eavcodes/desbravatech_kicad_libs/README.md

# desbravatech_kicad_libs
Most used Kicad symbols and footprints designed by us and collected on the internet. 

It's free and you are invited to contribute to this professional Kicad components and footprints lib!

If you have any questions, please send a message.
