eavcodes/desbravatech_kicad_libs/basic-configs/design_rule_kicad_value_01.png

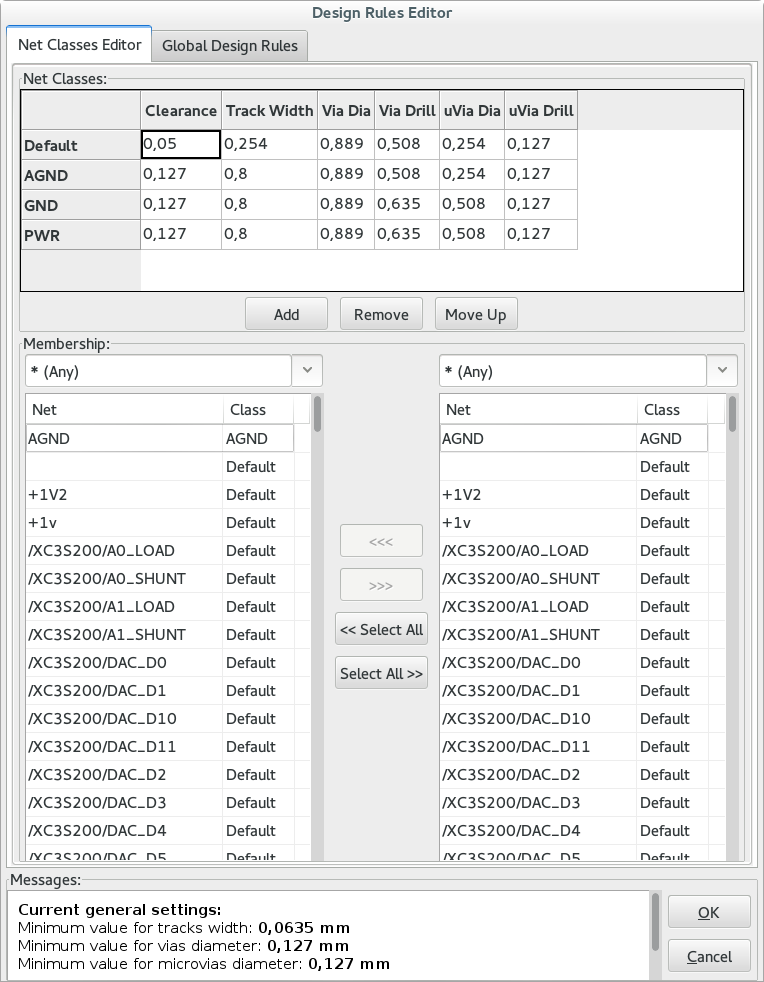
basic-configs/design_rule_kicad_value_01.png
