eavcodes/desbravatech_kicad_libs/basic-configs/design_rule_kicad_value_02.png

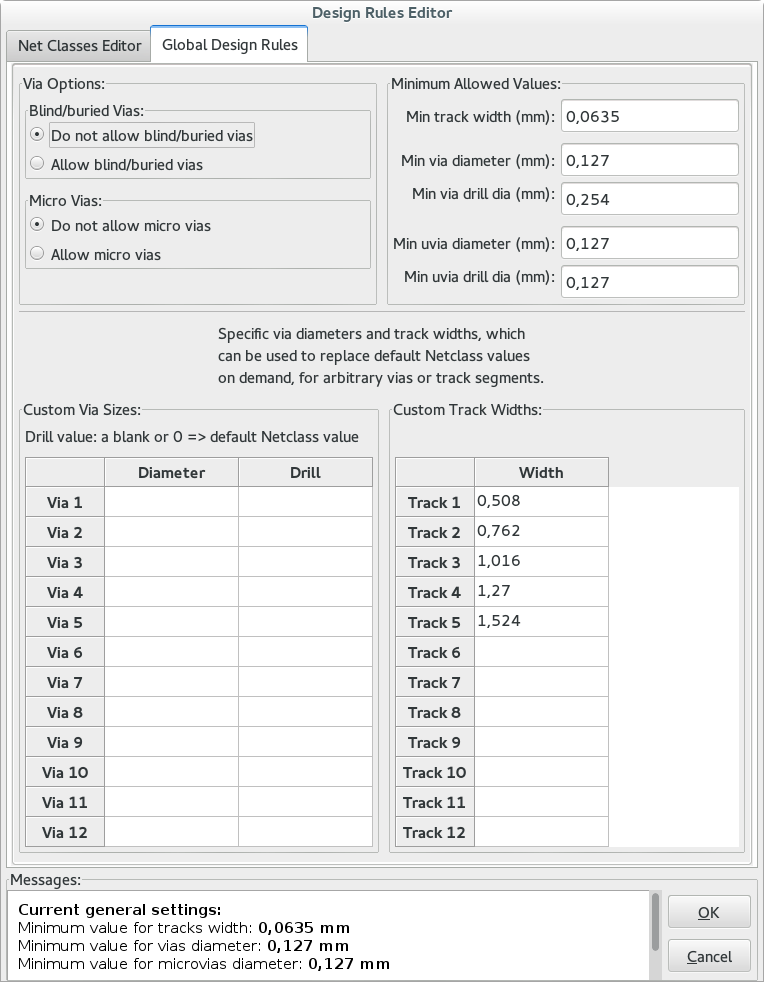
basic-configs/design_rule_kicad_value_02.png
