eavcodes/desbravatech_kicad_libs/designRules_2018.PNG

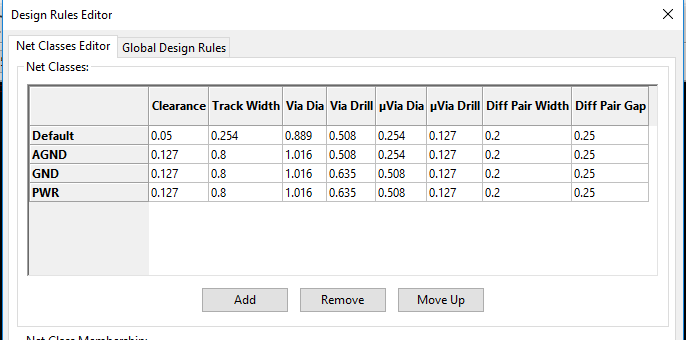
designRules_2018.PNG
