eavcodes/desbravatech_kicad_libs/designRulesGlobal_2018.PNG

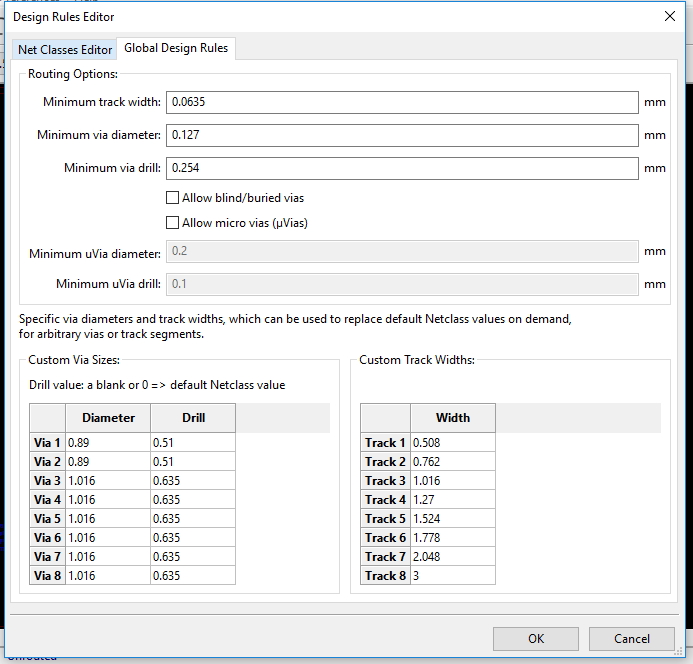
designRulesGlobal_2018.PNG
