eavcodes/desbravatech_kicad_libs/bom/saxon_windows_config_plugin.png

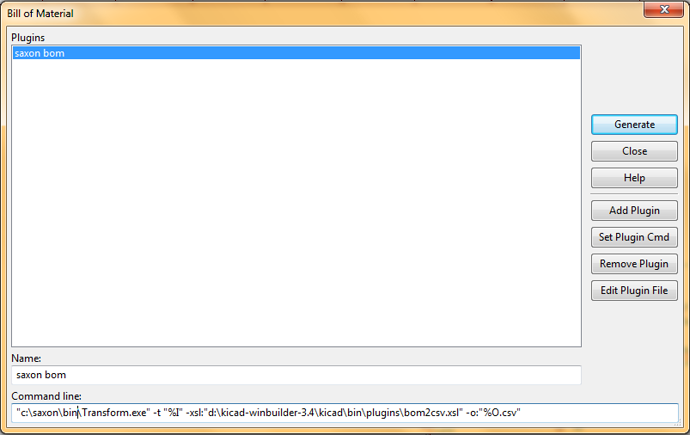
bom/saxon_windows_config_plugin.png
