eavcodes/desbravatech_kicad_libs/3d/J1021C.stp

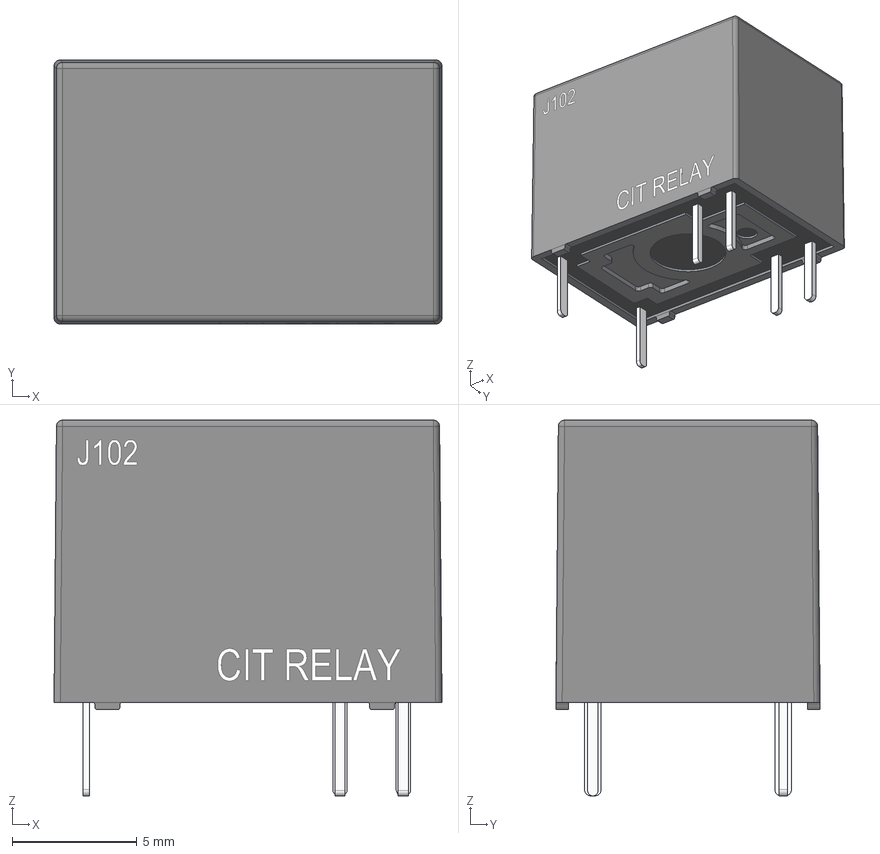
[picture p6: CAD file, 2025-11-07]
3d/J1021C.stp
15.5 x 10.6 x 15.1 mm
J102_Cover
J102_Terminal x 2
J102_Terminal_SQ x 2
J102_Terminal_2 x 2
J102_Base
