eavcodes/desbravatech_kicad_libs/footprints/3d_models/5223--3DModel-STEP-630548.STEP

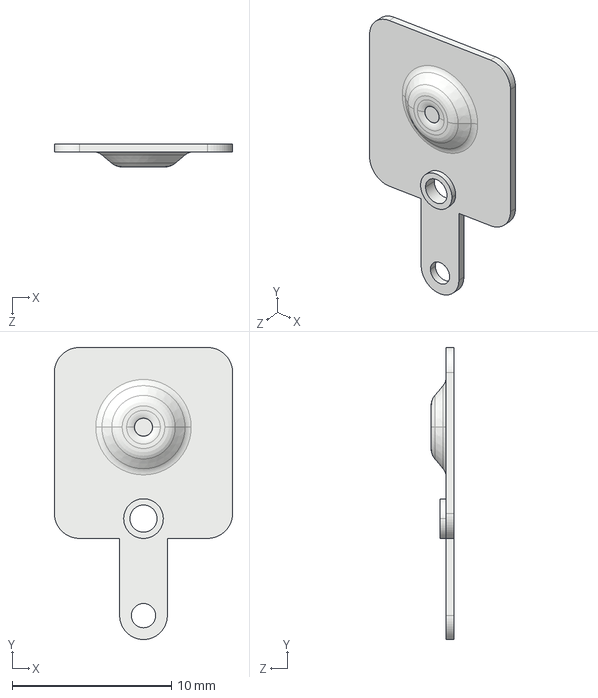
[picture p7: CAD file, 2025-08-11]
footprints/3d_models/5223--3DModel-STEP-630548.STEP
11.2 x 18.3 x 1.45 mm
