eavcodes/desbravatech_kicad_libs/3d/TS11-674-43-BK-100-RA-D.step

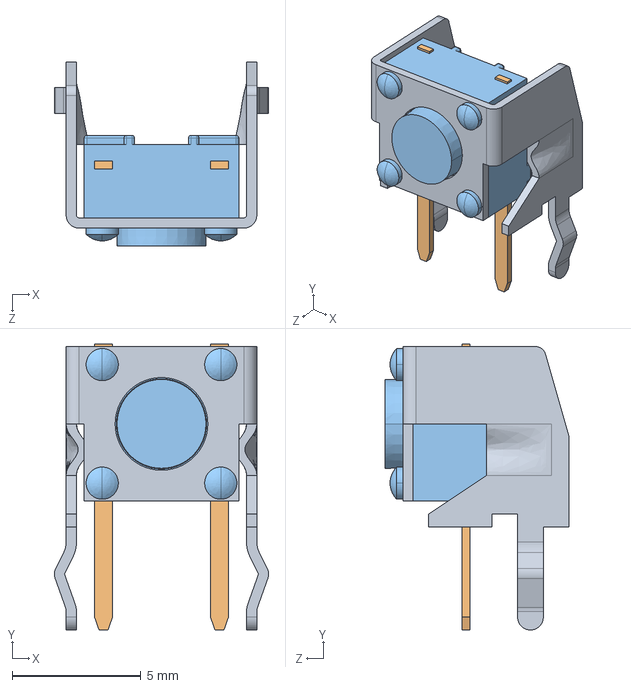
[picture p8: CAD file, 2025-10-24]
3d/TS11-674-43-BK-100-RA-D.step
8.31 x 11.1 x 7.15 mm
