eavcodes/desbravatech_kicad_libs/footprints/3d_models/SN-T5-1--3DModel-STEP-46669.STEP

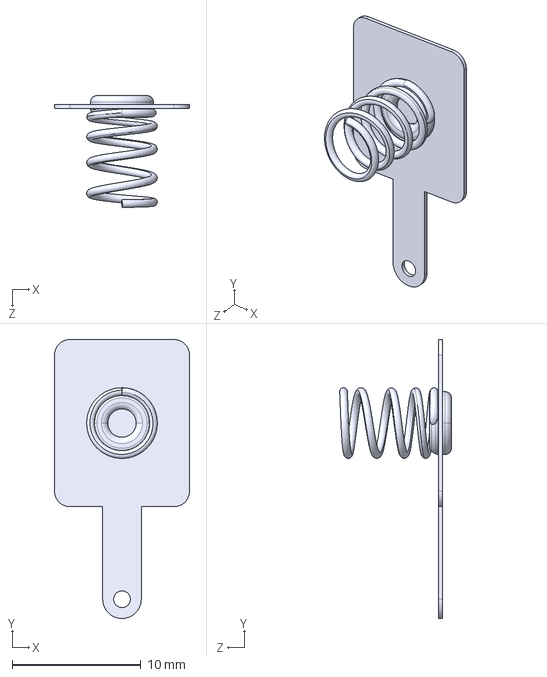
[picture p9: CAD file, 2025-08-11]
footprints/3d_models/SN-T5-1--3DModel-STEP-46669.STEP
10.5 x 21.7 x 8.70 mm
