eavcodes/desbravatech_kicad_libs/3d/Panasonic%20LQ%20Series%20Relays%20CAD%20Drawing%20ALQ1%20%28STEP%29.step

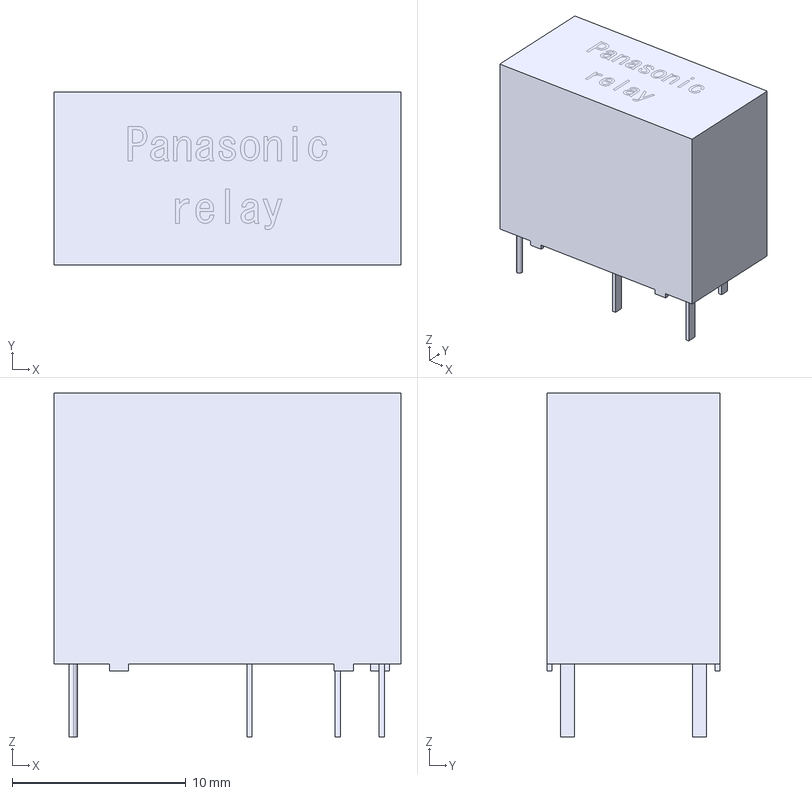
[picture p10: CAD file, 2025-10-24]
3d/Panasonic%20LQ%20Series%20Relays%20CAD%20Drawing%20ALQ1%20%28STEP%29.step
20.0 x 10.0 x 19.8 mm
