eavcodes/desbravatech_kicad_libs/footprints/3d_models/srr1208-101yl.stp

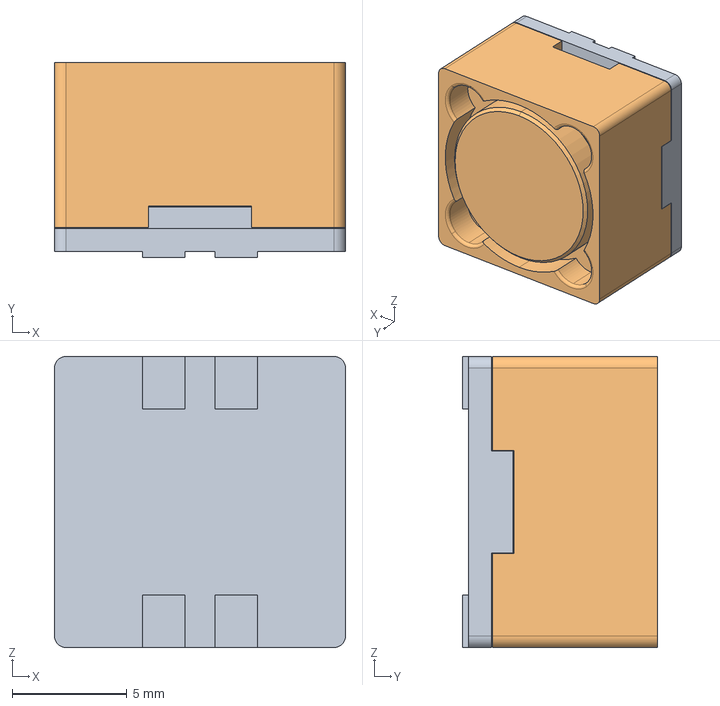
[picture p11: CAD file, 2024-09-12]
footprints/3d_models/srr1208-101yl.stp
12.7 x 8.50 x 12.7 mm
