eavcodes/desbravatech_kicad_libs/3d/TS32-7-35-BK-B-260-RA-SMT-TR.step

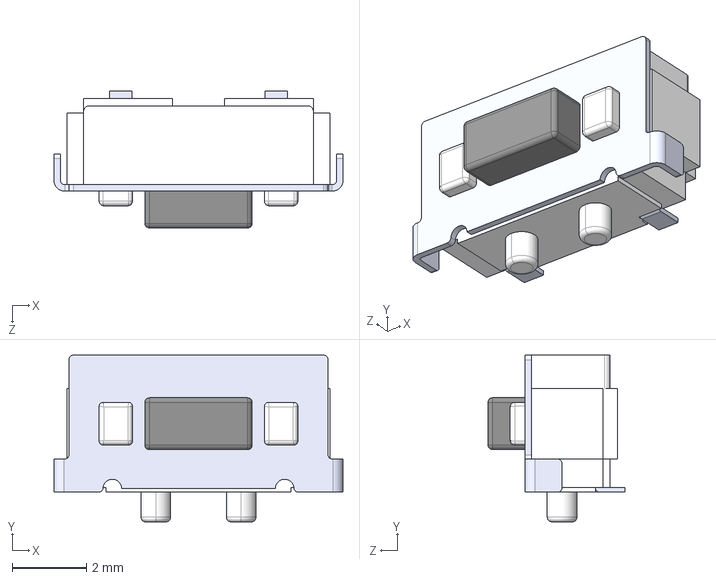
[picture p12: CAD file, 2025-10-24]
3d/TS32-7-35-BK-B-260-RA-SMT-TR.step
7.80 x 4.50 x 3.70 mm
