eavcodes/desbravatech_kicad_libs/footprints/3d_models/IRM-45.STEP

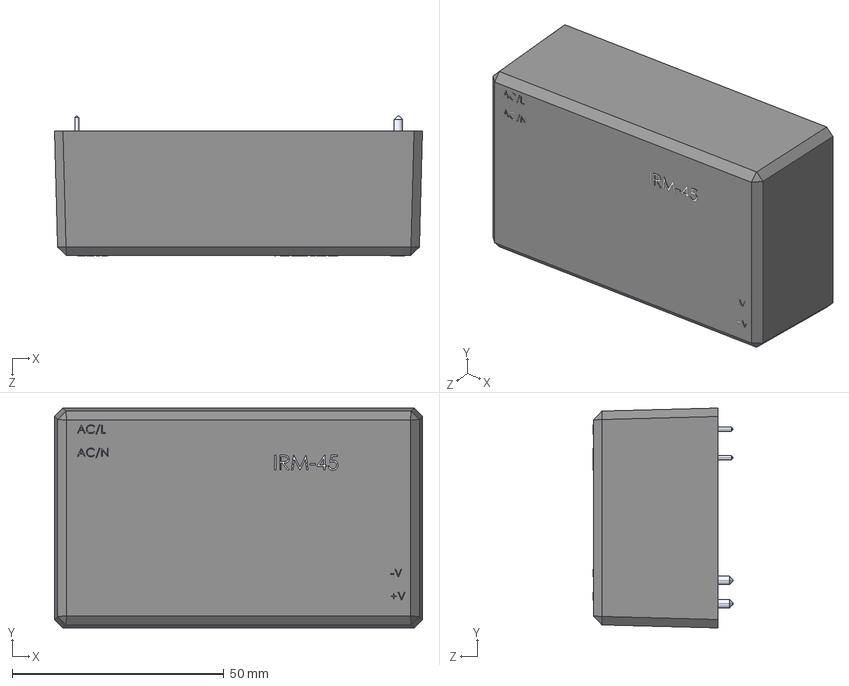
[picture p13: CAD file, 2024-09-12]
footprints/3d_models/IRM-45.STEP
87.0 x 52.0 x 33.1 mm
