eavcodes/desbravatech_kicad_libs/3d/PR8-5V-450-1A.step

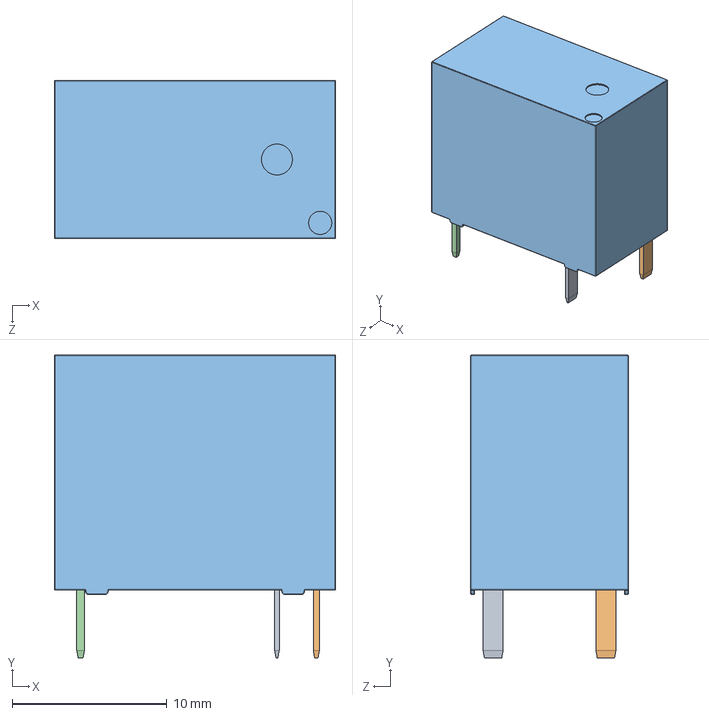
[picture p14: CAD file, 2025-09-16]
3d/PR8-5V-450-1A.step
18.2 x 19.6 x 10.2 mm
