eavcodes/desbravatech_kicad_libs/footprints/3d_models/ESP32-S3-WROOM-1-N16R8.STEP

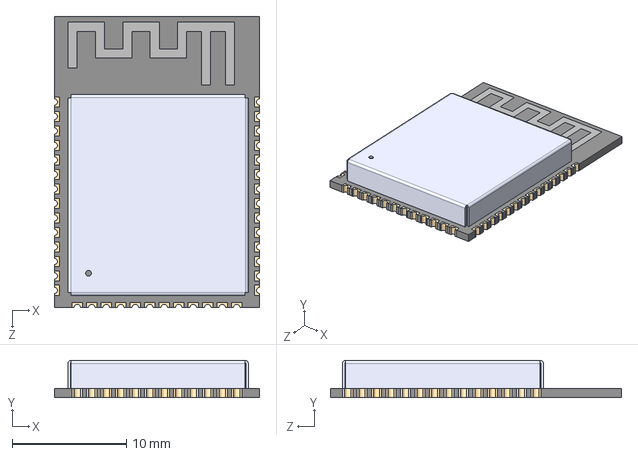
[picture p15: CAD file, 2024-02-02]
footprints/3d_models/ESP32-S3-WROOM-1-N16R8.STEP
18.0 x 3.25 x 25.5 mm
