eavcodes/desbravatech_kicad_libs/footprints/3d_models/CUI_DEVICES_SJ2-35364B-SMT-TR.step

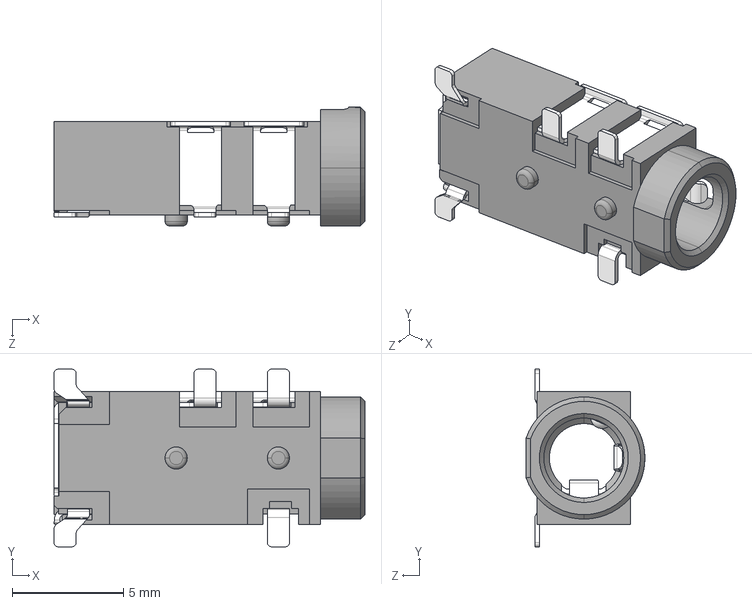
[picture p16: CAD file, 2024-01-29]
footprints/3d_models/CUI_DEVICES_SJ2-35364B-SMT-TR.step
14.0 x 8.00 x 5.35 mm
