eavcodes/desbravatech_kicad_libs/3d/V3PAN50-M3_I.step

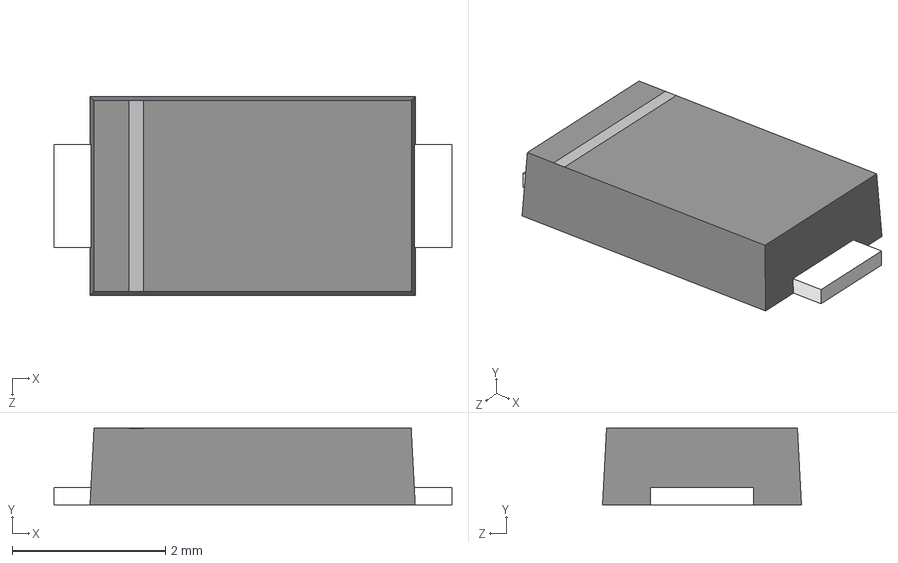
[picture p17: CAD file, 2025-02-25]
3d/V3PAN50-M3_I.step
5.20 x 1.00 x 2.60 mm
