eavcodes/desbravatech_kicad_libs/footprints/3d_models/USBC_16P_USB2.0_USB4105GFA120.step

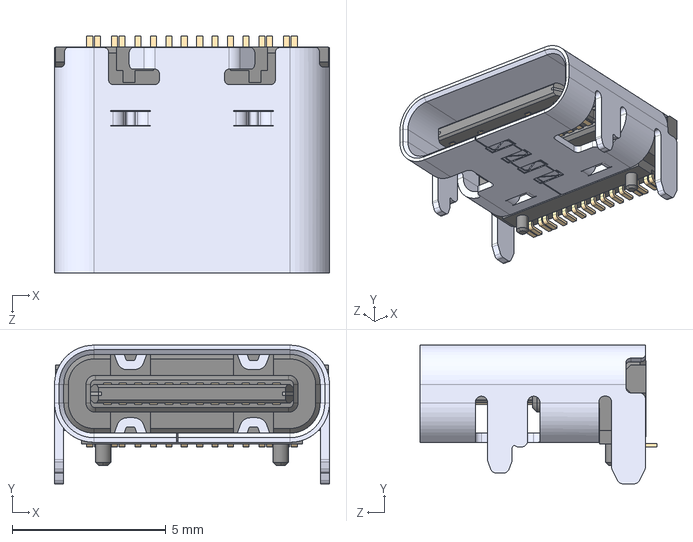
[picture p18: CAD file, 2023-12-15]
footprints/3d_models/USBC_16P_USB2.0_USB4105GFA120.step
8.94 x 4.51 x 7.71 mm
