eavcodes/desbravatech_kicad_libs/footprints/3d_models/BM83SM1-00TA--3DModel-STEP-56544.STEP

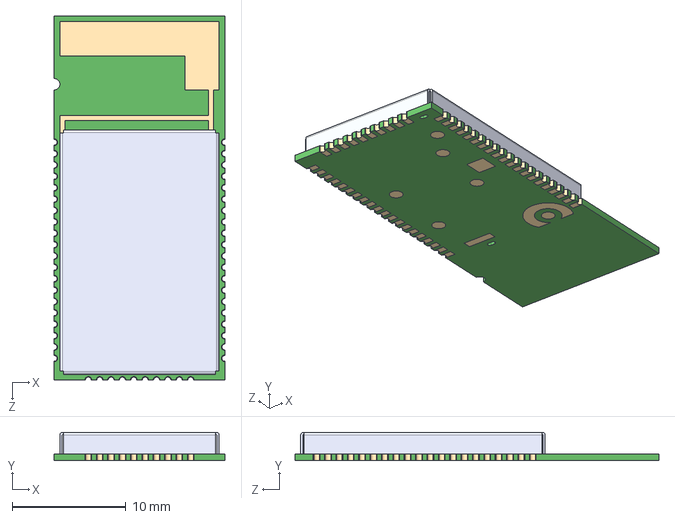
[picture p19: CAD file, 2023-12-12]
footprints/3d_models/BM83SM1-00TA--3DModel-STEP-56544.STEP
15.0 x 2.50 x 32.0 mm
