eavcodes/desbravatech_kicad_libs/footprints/3d_models/USB_C_MOLEX_2171750001.step

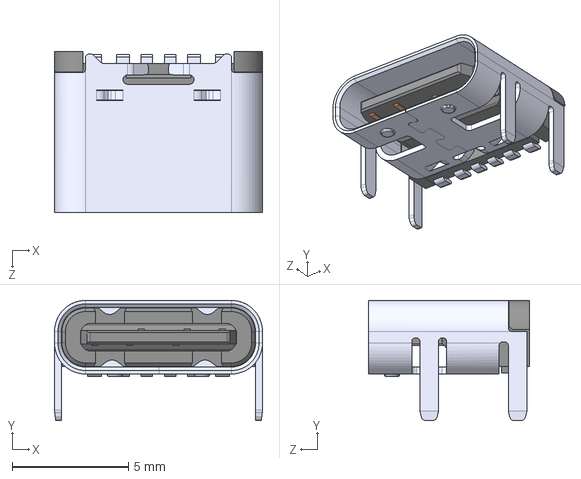
[picture p20: CAD file, 2023-12-12]
footprints/3d_models/USB_C_MOLEX_2171750001.step
8.94 x 5.16 x 6.90 mm
