eavcodes/desbravatech_kicad_libs/footprints/3d_models/SLP1210N6_SEM.step

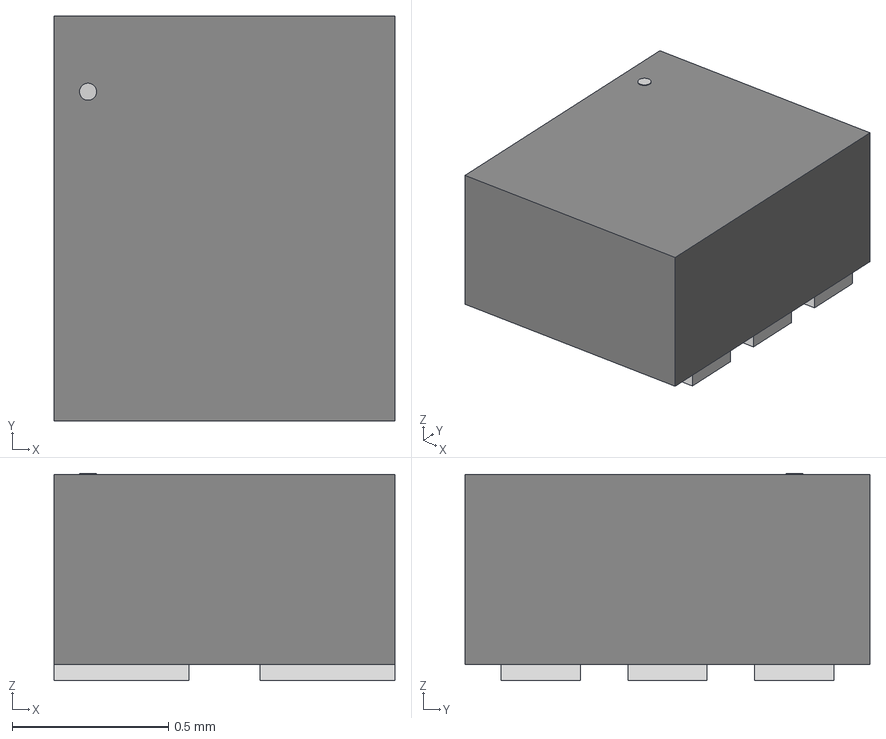
[picture p21: CAD file, 2023-11-29]
footprints/3d_models/SLP1210N6_SEM.step
1.09 x 1.30 x 0.663 mm
