eavcodes/desbravatech_kicad_libs/footprints/3d_models/HS3001.stp

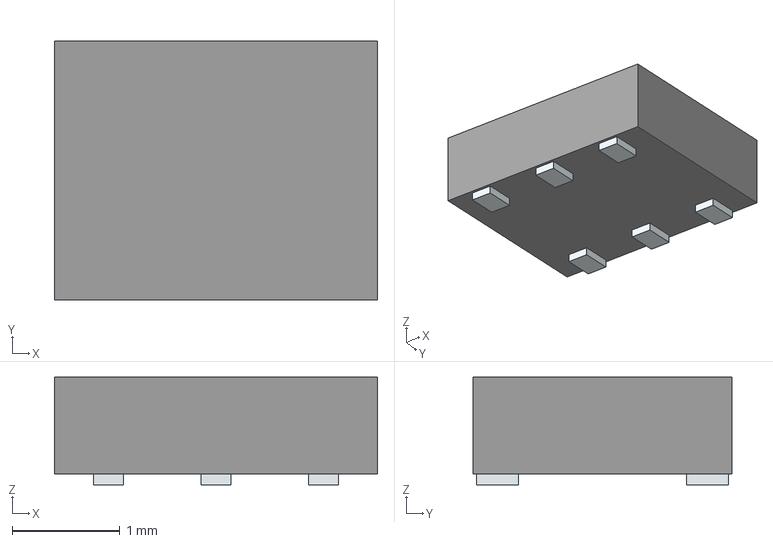
[picture p22: CAD file, 2023-11-29]
footprints/3d_models/HS3001.stp
3.00 x 2.41 x 1.00 mm
Pins
