eavcodes/desbravatech_kicad_libs/footprints/3d_models/TC33X-2-202E.step

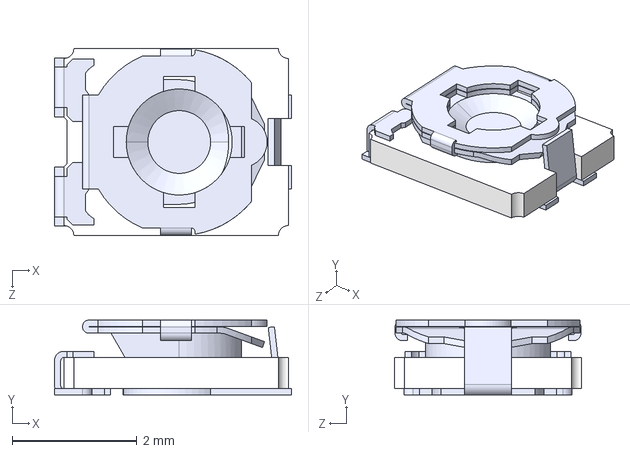
[picture p23: CAD file, 2023-11-29]
footprints/3d_models/TC33X-2-202E.step
3.80 x 1.20 x 3.00 mm
