eavcodes/desbravatech_kicad_libs/footprints/3d_models/R7FA4E2B93CFM#BA0.stp

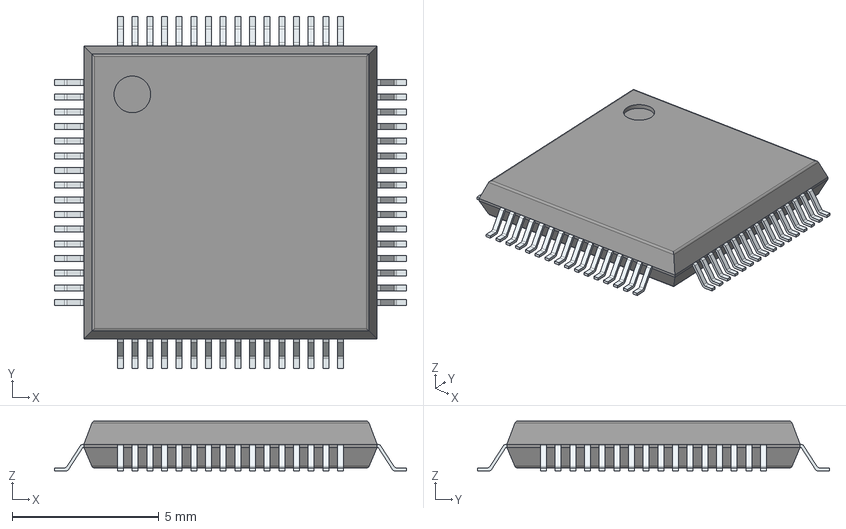
[picture p24: CAD file, 2023-11-29]
footprints/3d_models/R7FA4E2B93CFM#BA0.stp
12.0 x 12.0 x 1.70 mm
PinsArrayLR
PinsArrayTB
