eavcodes/desbravatech_kicad_libs/footprints/3d_models/LGA-6-40181.step

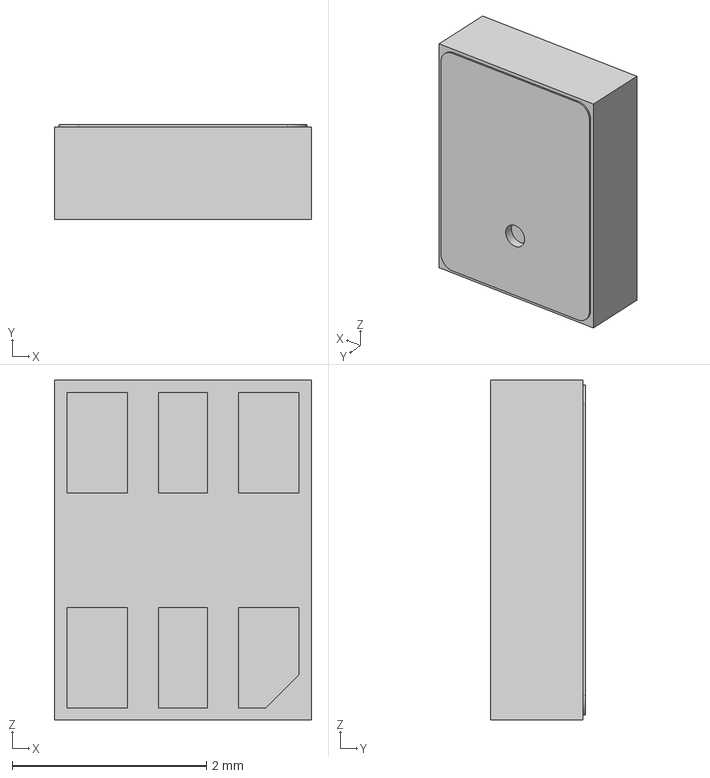
[picture p25: CAD file, 2023-08-16]
footprints/3d_models/LGA-6-40181.step
2.65 x 0.98 x 3.50 mm
