eavcodes/desbravatech_kicad_libs/footprints/3d_models/LFQFP-48-Renesas.stp

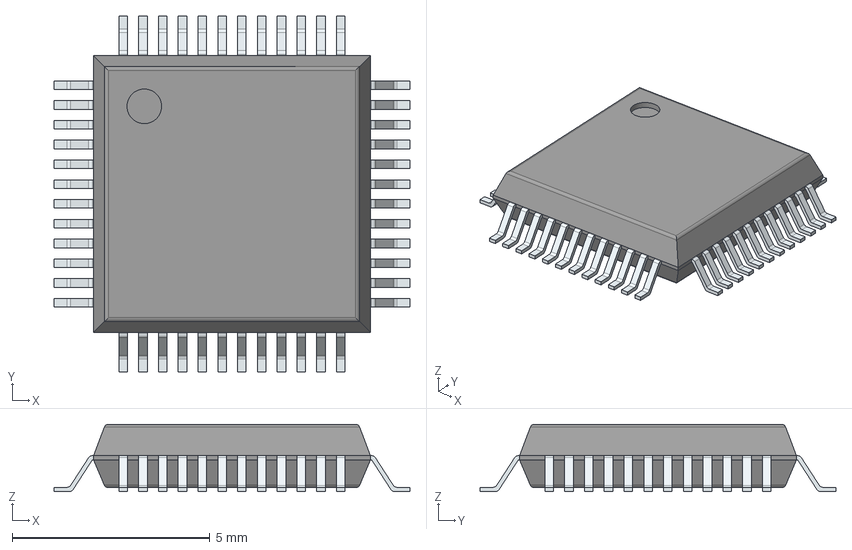
[picture p26: CAD file, 2023-06-05]
footprints/3d_models/LFQFP-48-Renesas.stp
9.00 x 9.00 x 1.70 mm
PinsArrayLR
PinsArrayTB
