eavcodes/desbravatech_kicad_libs/footprints/3d_models/AAVID_576602B_heat_sink.step

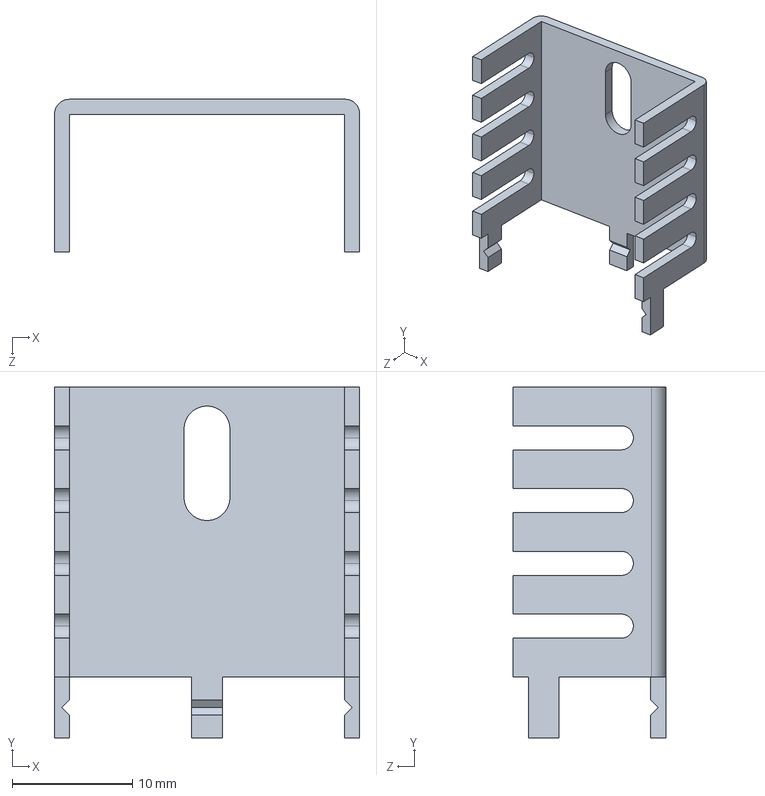
[picture p27: CAD file, 2022-03-22]
footprints/3d_models/AAVID_576602B_heat_sink.step
25.4 x 29.2 x 12.7 mm
