eavcodes/desbravatech_kicad_libs/footprints/3d_models/Thermalloy_6021bg.STEP

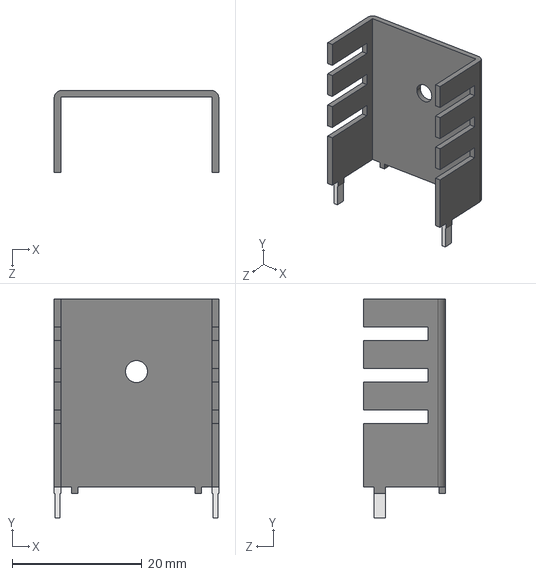
[picture p28: CAD file, 2022-03-22]
footprints/3d_models/Thermalloy_6021bg.STEP
25.4 x 33.8 x 12.7 mm
