eavcodes/desbravatech_kicad_libs/footprints/3d_models/LQFP64_7x7mm.step

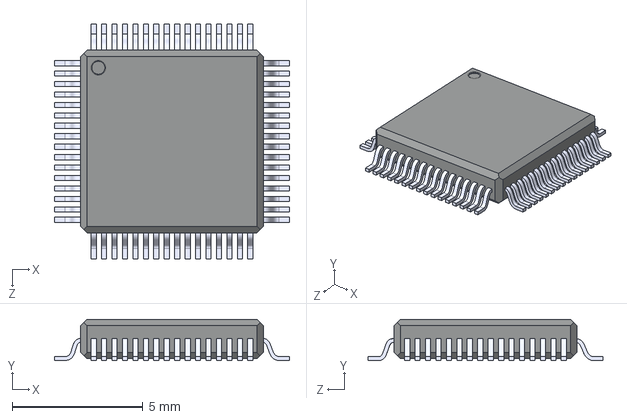
[picture p29: CAD file, 2022-03-16]
footprints/3d_models/LQFP64_7x7mm.step
9.00 x 1.58 x 9.00 mm
