eavcodes/desbravatech_kicad_libs/footprints/3d_models/LQFP64-10x10.step

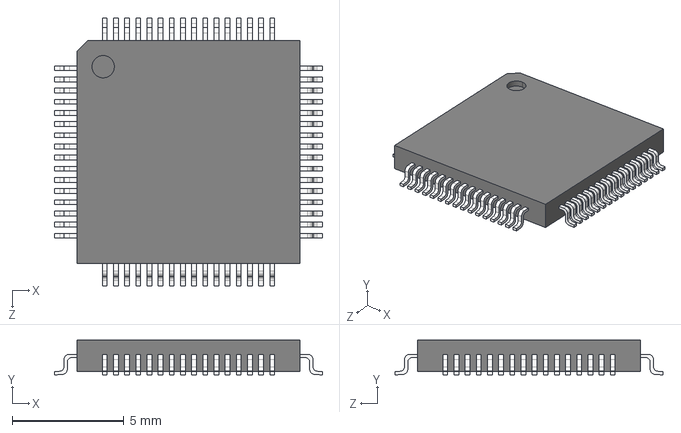
[picture p30: CAD file, 2022-03-16]
footprints/3d_models/LQFP64-10x10.step
12.0 x 1.56 x 12.0 mm
