eavcodes/desbravatech_kicad_libs/footprints/3d_models/RM-0505S.step

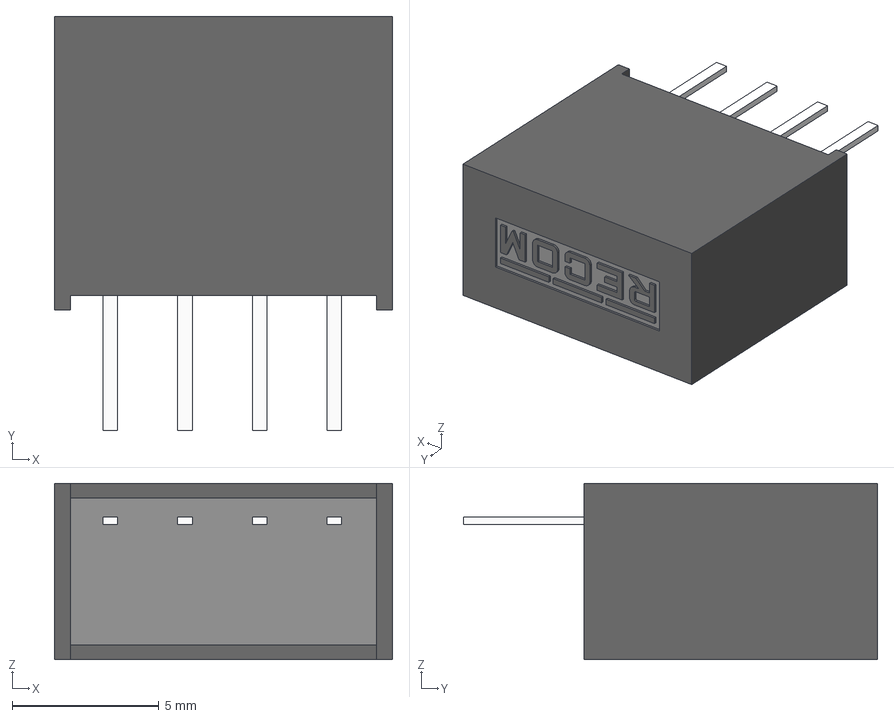
[picture p31: CAD file, 2022-02-24]
footprints/3d_models/RM-0505S.step
11.5 x 14.1 x 6.00 mm
