eavcodes/desbravatech_kicad_libs/(list of files, cad)

Other CAD files:
3d/0697H9160-02.step
footprints/3d_models/686110148922.step
footprints/3d_models/HR911105A.step
