eavcodes/desbravatech_kicad_libs/(commit log)

2020-07-09 added digikey symbols and footprints. Joined together symbols and footprints repositories
2020-07-09 added config files, basic design rules and bom plugin tutorial with Saxon
2020-07-15 Adicionado novo componente (símbolo e footprint)
    Adicionado TI TPS65131
2020-07-15 novo footprint BPM15-SERIES Murata
2020-07-15 BMP15-SERIES updated footprint
2020-07-16 update footprints and labels
2020-07-27 Added and updated mounting holes
    M1, M3, M4, M6 mounting holes
2020-07-29 Adicionado novos símbolos e footprints
2020-08-05 new item relay 5 pin
    Included new symbol. Relay 5 pin
2020-09-23 updated footprints
2020-10-14 Add Battery
2021-08-10 added items
    - TO-46-2 reverse footprint
    - SOP-18 footprint
2022-01-26 Create bionexus_symbols_lib.kicad_sym
    Migrate symbols lib to new KiCAD v6
2022-01-28 Update bionexus_symbols_lib.kicad_sym
    fixed symbol MX25V1635F grid position
2022-01-28 Update bionexus_symbols_lib.kicad_sym
    fixed symbols grid
2022-02-18 atualização de componentes
    adicionado componentes
    cpc5902
    dgd0506
    max 31865
    lmp91200
    rm0505s
2022-02-18 migrated symbols libs to kicad 6
2022-02-21 ajuste estetico do back gorund de componentes recentes
2022-02-24 added RM-0505S footprint
    Created 3d_models folder for 3d view
    [RM-0505S.step]
2022-03-08 added new symbols
    . BD41041FJ CAN bus transceiver
    . PIC18F27Q84 MCU 8-bit Microchip
    . TMCS1108 hall-effect current sensor
2022-03-10 Update bionexus_symbols_lib.kicad_sym
    Added TMCS1108A hall-effect current sensor from Texas Instruments
2022-03-14 added SSOP-5 footprint
    [SSOP-5.step]
2022-03-14 added BU12TD3WG symbol
    Voltage regulator 1.2V
2022-03-14 added BUxxTD3WG voltage regulators series from Rohm semiconductor
2022-03-14 sata header symbol & footprint
2022-03-14 added hsec8-130 0.8 mm pitch edge card connector
    samtec inc
2022-03-15 adicionada fonte lambda KMD15-55 e powerconenctor com chave
2022-03-16 added new symbol & footprint
    64-LQFP 7x7mm 0.4mm pitch footprint with 3D model
    AD9238 12-bit ADC conv from Analog Devices
    [LQFP64-10x10.step, LQFP64_7x7mm.step]
2022-03-18 Create HSEC8-130-Board-Connector.kicad_mod
    HSEC8-130 on-board footprint card edge
2022-03-18 update footprints
    update some footprints to improve usage
2022-03-18 Update ASVMB_OSC.kicad_mod
    footprint improved for ASVMB oscilator
2022-03-18 Update HSEC8-130-Board-Connector.kicad_mod
    updated edge cuts width to 0.1mm
2022-03-22 heat sink aavid 593002B045 channel
    [AAVID_576602B_heat_sink.step, Thermalloy_6021bg.STEP]
2022-03-22 Update AAVID HEATSINK 593002B03400G TO-220.kicad_mod
2022-03-22 Update AAVID HEATSINK 593002B03400G TO-220.kicad_mod
    adjusted user drawing for TO-220 pinout position
2022-03-25 adição de alguns componentes
    esp32 e mosfet p19n15
2022-03-25 adição de componentes
    ads1100xx
2022-08-10 added HR911105A RJ45 Led connector
    [HR911105A.step]
2022-08-10 added wurth FPC 10P connector
    [686110148922.step]
2023-02-14 Update bionexus_symbols_lib.kicad_sym
    Migration to new KiCAD 7
2023-03-28 Update bionexus_symbols_lib.kicad_sym
    Added ADR39x voltage reference 4.096V
2023-03-30 Update bionexus_symbols_lib.kicad_sym
    Added LM567 tone detector
2023-05-20 Update bionexus_symbols_lib.kicad_sym
    Added TMP107-Q1
2023-06-05 atualizacao
    ajustei alguns componentes smd para montagem smd ao inves de furo passante
2023-06-05 added LFQFP-48_pitch0.5mm
    [LFQFP-48-Renesas.stp]
2023-07-26 Update bionexus_symbols_lib.kicad_sym
    Added HDC302x WSON Umidity Sensor
2023-07-26 Update bionexus_symbols_lib.kicad_sym
    Added DS28E17Q 1-wire to I2C master bridge
2023-08-16 update footprint lga6
    [LGA-6-40181.step]
2023-08-21 adicionado o footprint do modulo lora
2023-08-23 atualizacao humidade
    [HS3001.stp]
2023-09-13 adicionado footprint conector 16
2023-09-13 Create LSSOP 30 M new.kicad_mod
2023-11-29 Added symbol for Renesas R7FA4 MCU
    . symbol
    . footprint
    . 3D model
    [R7FA4E2B93CFM#BA0.stp, TC33X-2-202E.step]
2023-11-29 Added RCLAMP0582N
    [SLP1210N6_SEM.step]
2023-12-12 usb connectors and bm83 ble audio module
    [BM83SM1-00TA--3DModel-STEP-56544.STEP, USB_C_MOLEX_2171750001.step]
2024-01-29 added new 3d models and symbols
    [CUI_DEVICES_SJ2-35364B-SMT-TR.step]
2024-02-02 ESP32-S3 module
    [ESP32-S3-WROOM-1-N16R8.STEP]
2024-02-08 update footprints
2024-04-11 Create 64-LQFP 10x10mm 0.5mm pitch
    Create 64-LQFP 10x10mm 0.5mm pitch IC footprint
2024-06-28 relay symbol and footprint
2024-09-12 added IRM-45 power source ac-dc 3D model
    [IRM-45.STEP]
2024-09-12 3D models added
    [srr1208-101yl.stp]
2025-02-25 new symbols and footprint diode DO-221BC
    High current 5A diode footprint
    [V3PAN50-M3_I.step]
2025-07-13 esp-wroom-03-port footprint
2025-08-11 Added PIR Sensor and battery footprint
    [5223--3DModel-STEP-630548.STEP, SN-T5-1--3DModel-STEP-46669.STEP]
2025-09-16 Update ESP8684-W03 footprint
    Update esp-8684-wroom03 footprint
    PR8 Relay footprint added
    [0697H9160-02.step, PR8-5V-450-1A.step]
2025-10-24 New Relay and Plug footprints
    [Panasonic%20LQ%20Series%20Relays%20CAD%20Drawing%20ALQ1%20%28STEP%29.step, TS11-674-43-BK-100-RA-D.step, TS32-7-35-BK-B-260-RA-SMT-TR.step]
